luidybp/controlador_2_motores/PCB/Projeto/unifilar.kicad_pcb

## KiCad design PCB/Projeto/unifilar.kicad_pcb (2026-10-10)

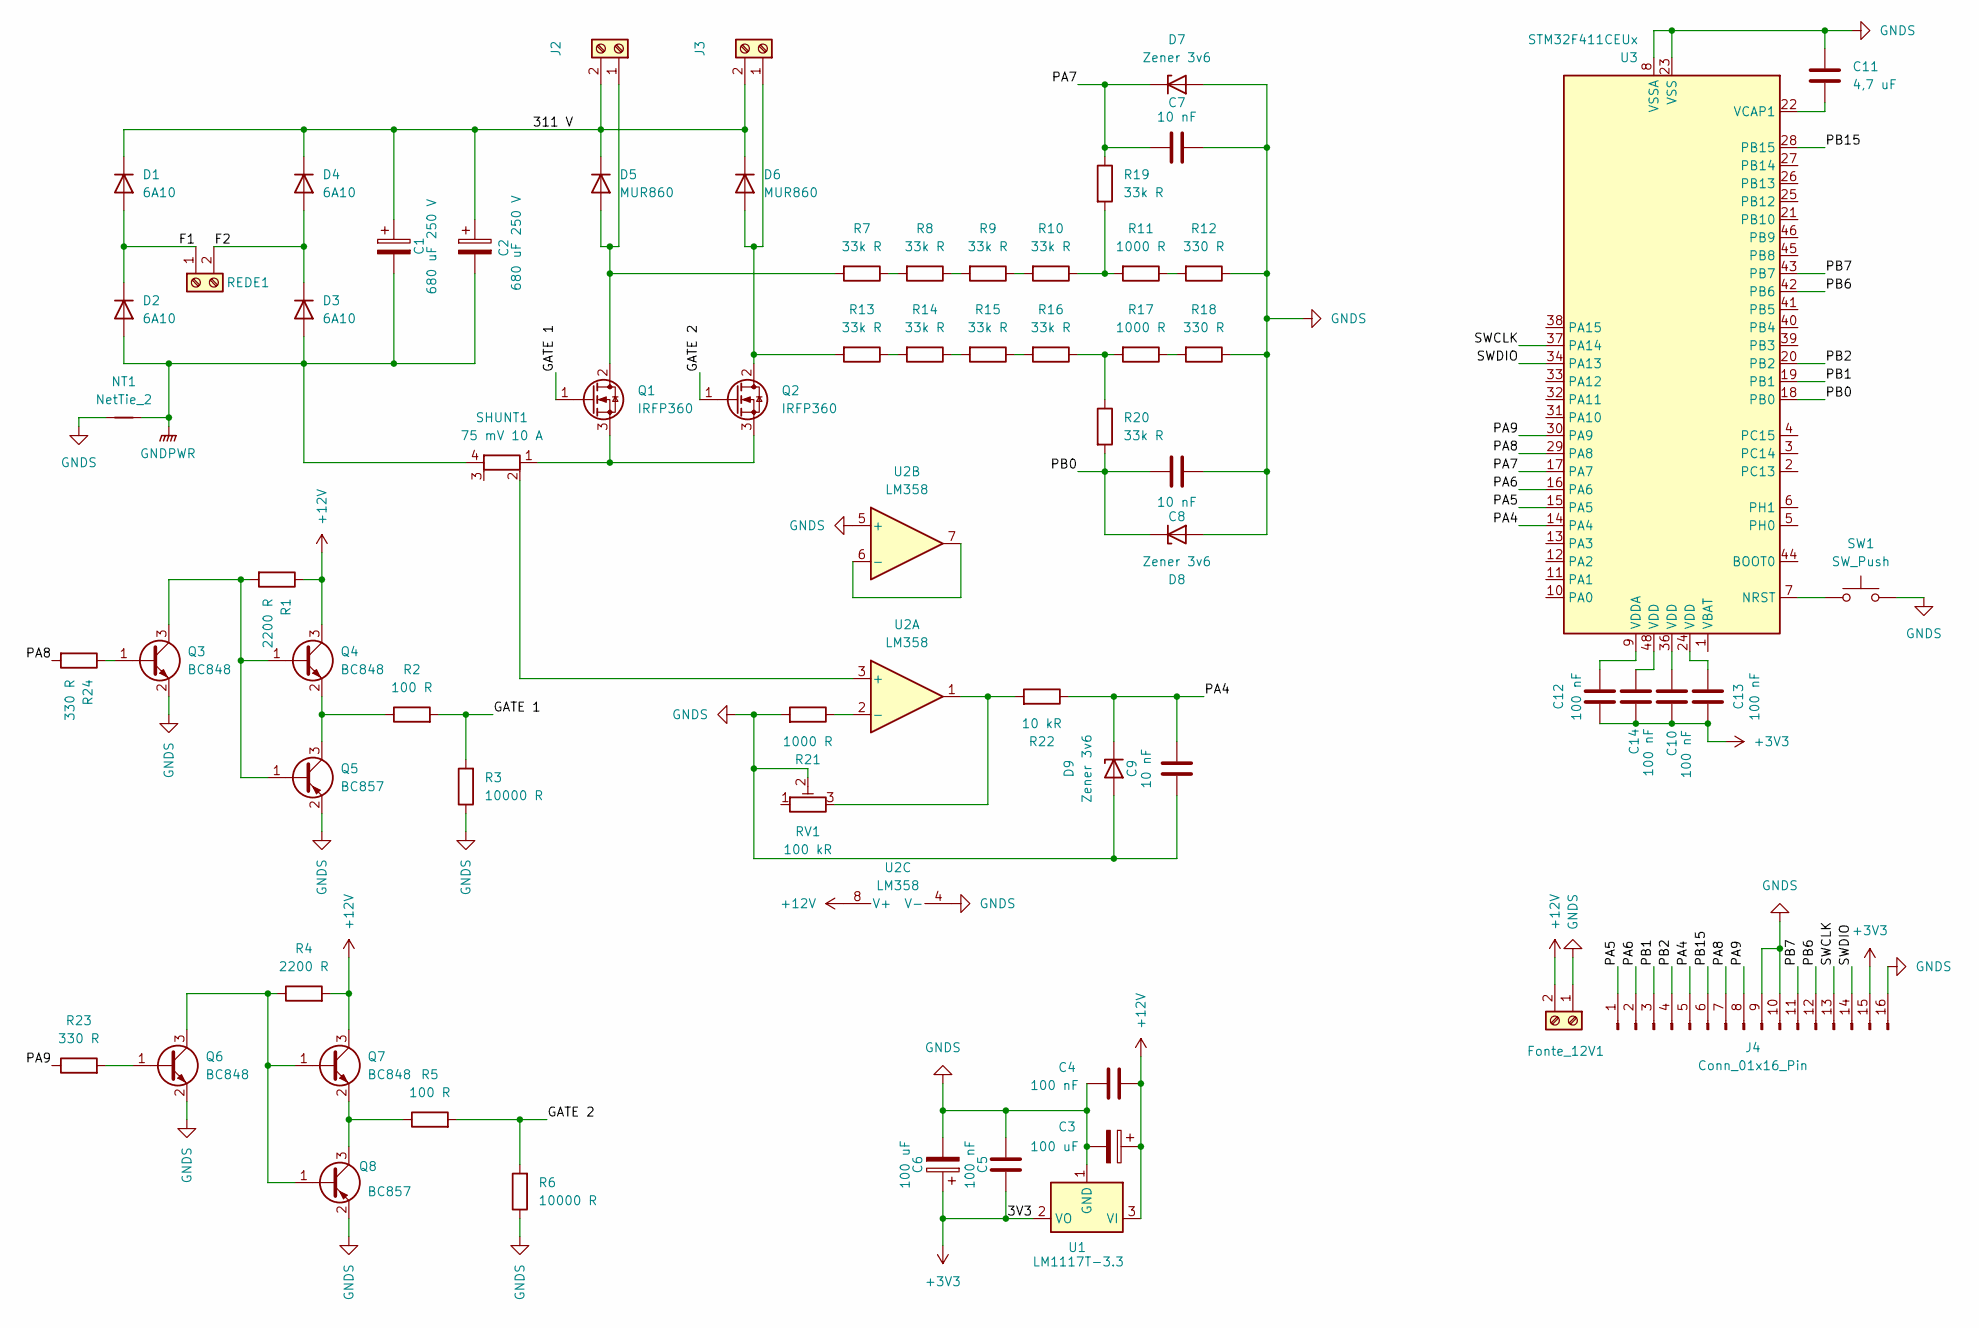
[picture p1: schematic unifilar.kicad_sch, Controlador dos motores CC]

Parts:
C1, C2: 680 uF 250 V; CP_Radial_D35.0mm_P10.00mm_SnapIn
C3, C6: 100 uF; CP_Elec_6.3x5.4
C4, C5, C10, C12, C13, C14: 100 nF; C_1206_3216Metric_Pad1.33x1.80mm_HandSolder
C7, C8, C9: 10 nF; C_1206_3216Metric_Pad1.33x1.80mm_HandSolder
C11: 4,7 uF; C_1206_3216Metric_Pad1.33x1.80mm_HandSolder
D1, D2, D3, D4: 6A10; D_5KPW_P12.70mm_Horizontal
D5, D6: MUR860; TO-220-2_Horizontal_TabUp
D7, D8, D9: Zener 3v6; D_SOD-123F
Fonte_12V1: TerminalBlock_Phoenix_MKDS-1,5-2-5.08_1x02_P5.08mm_Horizont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
J2, J3: TerminalBlock_Phoenix_MKDS-1,5-2-5.08_1x02_P5.08mm_Horizont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
J4: Conn_01x16_Pin; PinHeader_1x16_P1.00mm_Horizontal
NT1: NetTie_2; NetTie-2_SMD_Pad0.5mm
Q1, Q2: IRFP360; TO-247-3_Horizontal_TabUp
Q3, Q4, Q6, Q7: BC848; SOT-23
Q5, Q8: BC857; SOT-23
R1, R4: 2200 R; R_1206_3216Metric_Pad1.30x1.75mm_HandSolder
R2, R5: 100 R; R_1206_3216Metric_Pad1.30x1.75mm_HandSolder
R3, R6: 10000 R; R_1206_3216Metric_Pad1.30x1.75mm_HandSolder
R7, R8, R9, R10, R13, R14, R15, R16, R19, R20: 33k R; R_1206_3216Metric_Pad1.30x1.75mm_HandSolder
R11, R17, R21: 1000 R; R_1206_3216Metric_Pad1.30x1.75mm_HandSolder
R12, R18, R23, R24: 330 R; R_1206_3216Metric_Pad1.30x1.75mm_HandSolder
R22: 10 kR; R_1206_3216Metric_Pad1.30x1.75mm_HandSolder
REDE1: TerminalBlock_Phoenix_MKDS-1,5-2-5.08_1x02_P5.08mm_Horizont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
RV1: 100 kR; Potentiometer_Bourns_3296W_Vertical
SHUNT1: 75 mV 10 A; TerminalBlock_Phoenix_MKDS-1,5-4_1x04_P5.00mm_Horizontal
SW1: SW_Push; SW_PUSH_6mm
U1: LM1117T-3.3; TO-220-3_Horizontal_TabUp
U2: LM358
U3: STM32F411CEUx; QFN-48-1EP_7x7mm_P0.5mm_EP5.6x5.6mm

Connections:
+3V3: C5.2, C6.1, C10.1, C12.1, C13.1, C14.1, J4.15, U1.2 (VO)
+12V: C3.1, C4.2, Fonte_12V1.2, Q4.3 (C), Q7.3 (C), R1.1, R4.2, U1.3 (VI), U2.8 (V+)
/311 V: C1.1, C2.1, D1.1 (K), D4.1 (K), D5.1 (K), D6.1 (K), J2.2, J3.2
/F1: D1.2 (A), D2.1 (K), REDE1.1
/F2: D3.1 (K), D4.2 (A), REDE1.2
/GATE 1: Q1.1 (G), R2.2, R3.2
/GATE 2: Q2.1 (G), R5.2, R6.2
/PA4: C9.1, D9.1 (K), J4.5, R22.1, U3.14 (PA4)
/PA5: J4.1, U3.15 (PA5)
/PA6: J4.2, U3.16 (PA6)
/PA7: C7.1, D7.1 (K), R19.1, U3.17 (PA7)
/PA8: J4.7, R24.2, U3.29 (PA8)
/PA9: J4.8, R23.1, U3.30 (PA9)
/PB0: C8.1, D8.1 (K), R20.2, U3.18 (PB0)
/PB1: J4.3, U3.19 (PB1)
/PB2: J4.4, U3.20 (PB2)
/PB6: J4.12, U3.42 (PB6)
/PB7: J4.11, U3.43 (PB7)
/PB15: J4.6, U3.28 (PB15)
/SWCLK: J4.13, U3.37 (PA14)
/SWDIO: J4.14, U3.34 (PA13)
GNDPWR: C1.2, C2.2, D2.2 (A), D3.2 (A), NT1.1, SHUNT1.4
GNDS: C3.2, C4.1, C5.1, C6.2, C7.2, C8.2, C9.2, C11.1, D7.2 (A), D8.2 (A), D9.2 (A), Fonte_12V1.1, J4.9, J4.10, J4.16, NT1.2, Q3.2 (E), Q5.2 (E), Q6.2 (E), Q8.2 (E), R3.1, R6.1, R12.1, R18.1, R21.2, RV1.2, SW1.2, U1.1 (GND), U2.4 (V-), U2.5 (+), U3.8 (VSSA), U3.23 (VSS), U3.35 (VSS), U3.47 (VSS), U3.49 (VSS)
unnamed: C10.2, U3.36 (VDD)
unnamed: C13.2, U3.24 (VDD)
unnamed: C14.2, U3.48 (VDD)
unnamed: D5.2 (A), J2.1, Q1.2 (D), R7.2
unnamed: D6.2 (A), J3.1, Q2.2 (D), R13.2
unnamed: Q1.3 (S), Q2.3 (S), SHUNT1.1
unnamed: Q3.1 (B), R24.1
unnamed: Q3.3 (C), Q4.1 (B), Q5.1 (B), R1.2
unnamed: Q4.2 (E), Q5.3 (C), R2.1
unnamed: Q6.1 (B), R23.2
unnamed: Q6.3 (C), Q7.1 (B), Q8.1 (B), R4.1
unnamed: Q7.2 (E), Q8.3 (C), R5.1
unnamed: R7.1, R8.2
unnamed: R8.1, R9.2
unnamed: R10.1, R11.2, R19.2
unnamed: R9.1, R10.2
unnamed: R11.1, R12.2
unnamed: R13.1, R14.2
unnamed: R14.1, R15.2
unnamed: R15.1, R16.2
unnamed: R16.1, R17.2, R20.1
unnamed: R17.1, R18.2
unnamed: R22.2, RV1.3, U2.1
unnamed: SHUNT1.2, U2.3 (+)
unnamed: R21.1, U2.2 (-)
unnamed: U2.6 (-), U2.7
unnamed: SW1.1, U3.7 (NRST)
unnamed: C11.2, U3.22 (VCAP1)
unnamed: C12.2, U3.9 (VDDA)

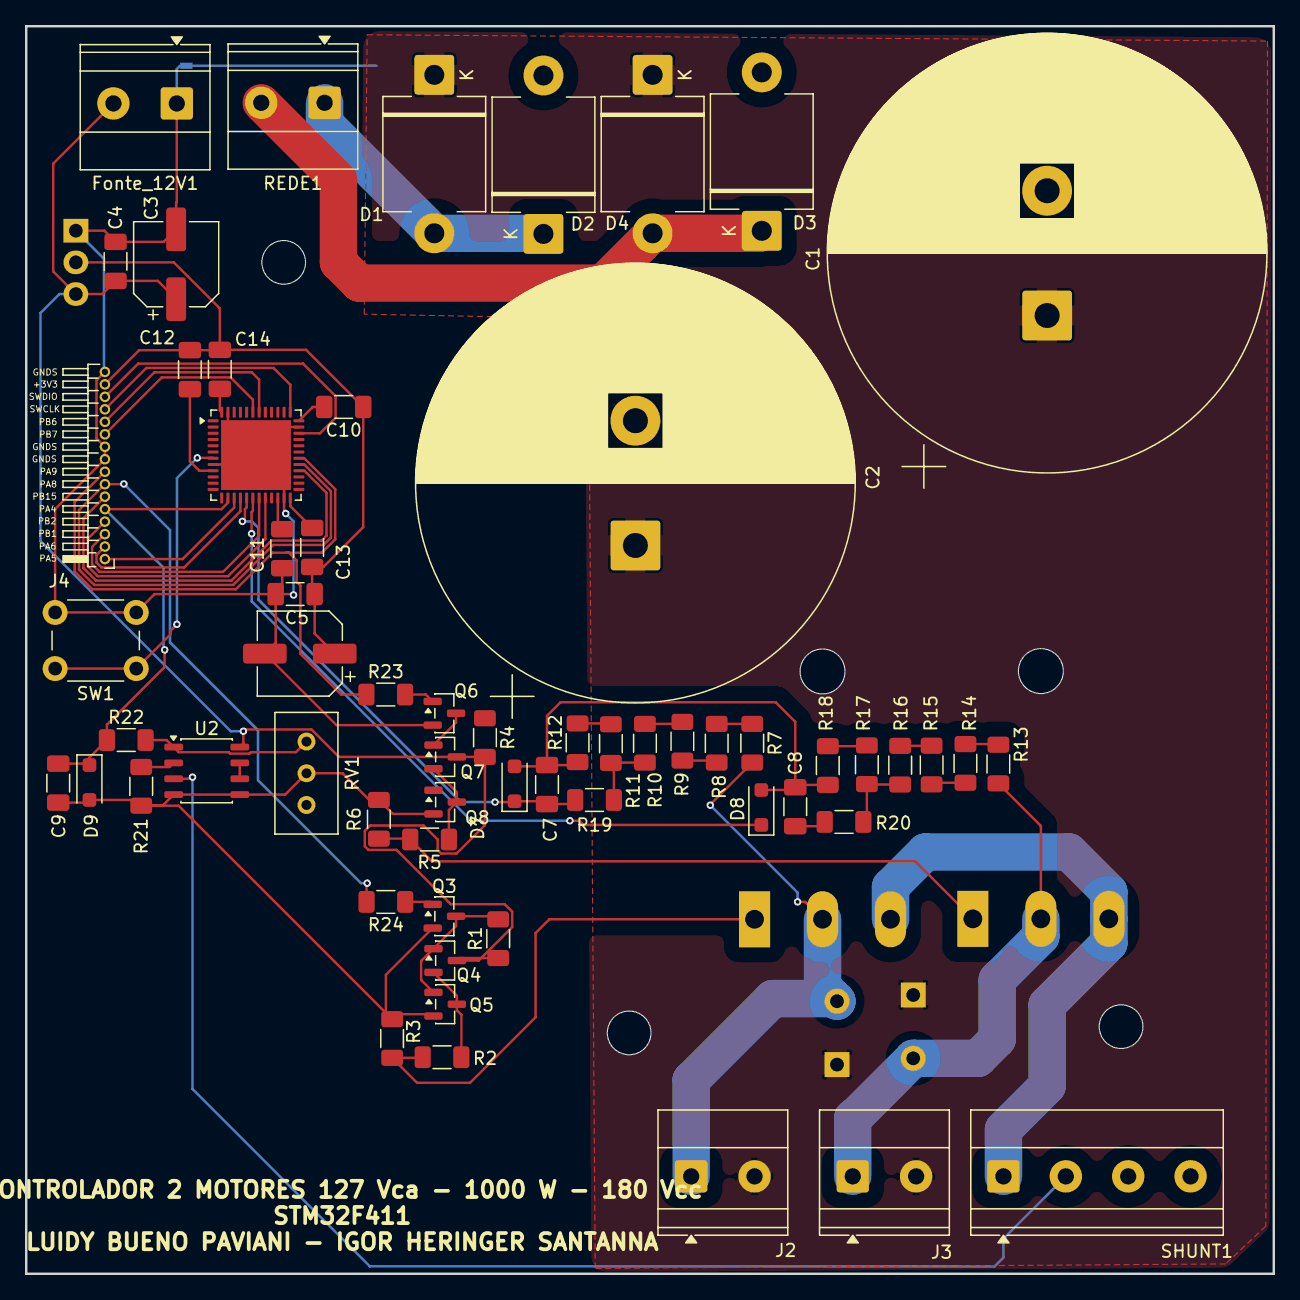
[picture p2: board unifilar.kicad_pcb from above]

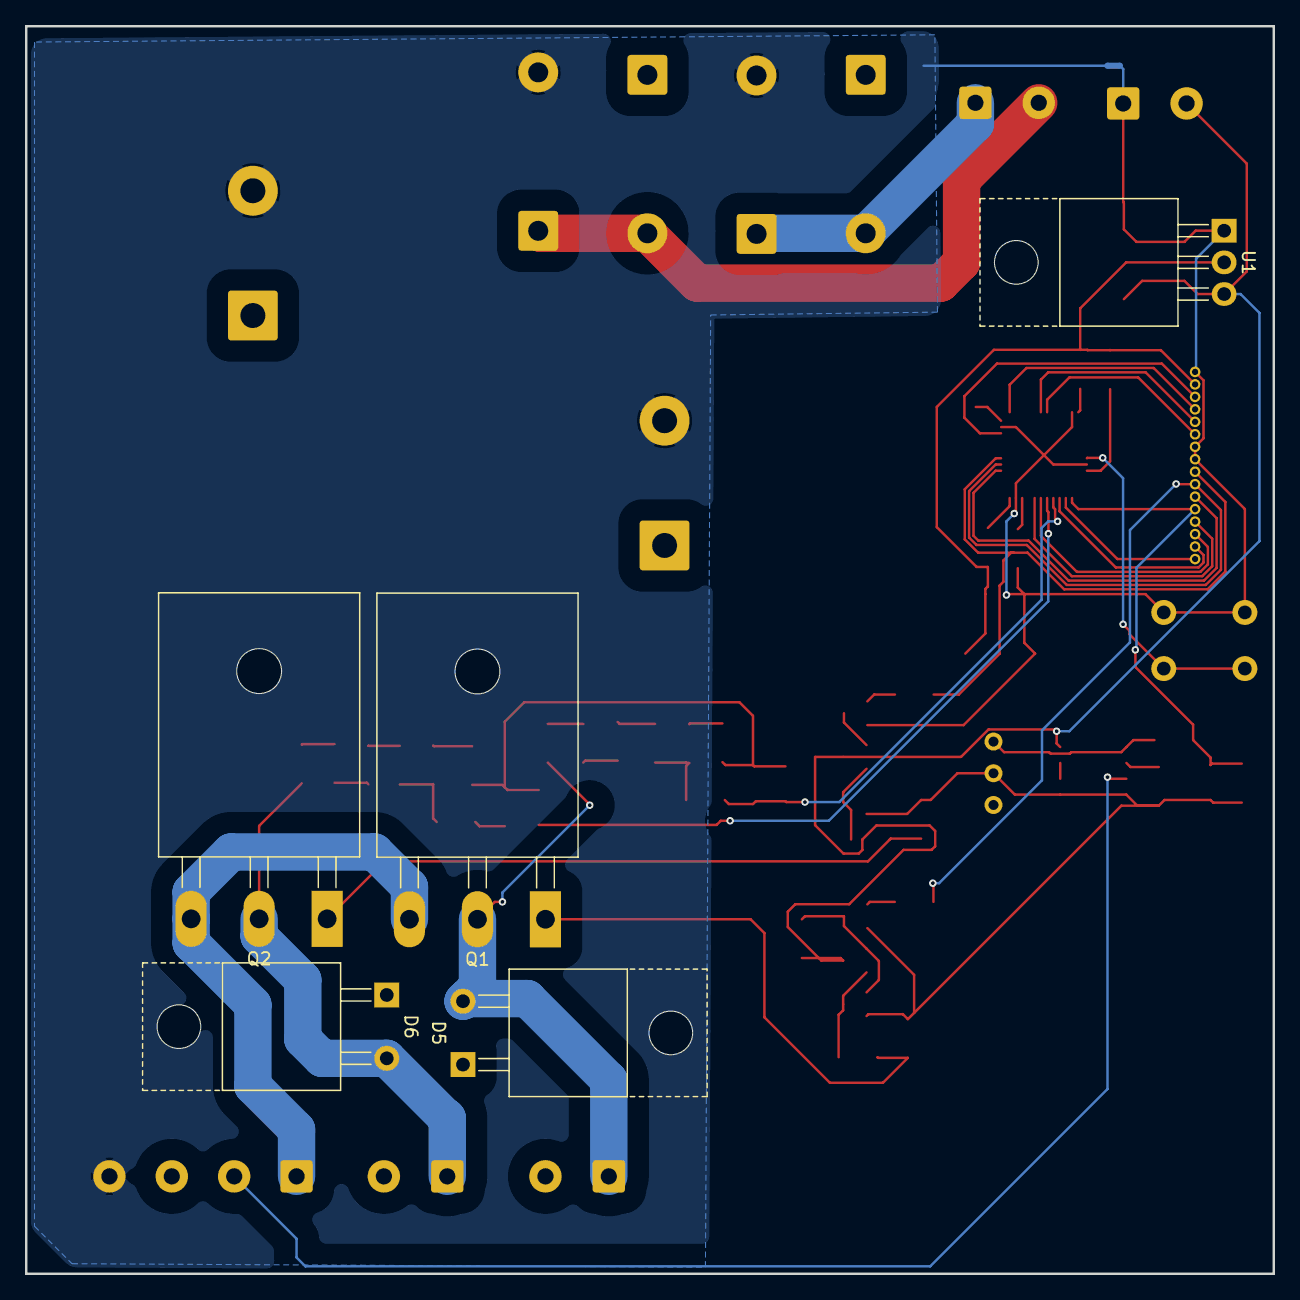
[picture p3: board unifilar.kicad_pcb from below]

Board: 2 copper layers, 100.0 x 100.0 mm, 67 parts (6 on the bottom side), 52 nets.
