luidybp/controlador_2_motores/tcc/tcc.ioc

Mcu.UserName=STM32F411CEUx
PA13.Signal=SYS_JTMS-SWDIO
PA14.Signal=SYS_JTCK-SWCLK
PA4.GPIO_Label=shunt
PA4.Signal=ADCx_IN4
PA5.GPIO_Label=pot1
PA5.Signal=ADCx_IN5
PA6.GPIO_Label=pot2
PA6.Signal=ADCx_IN6
PA7.GPIO_Label=emf1
PA7.Signal=ADCx_IN7
PA8.GPIO_Label=pwm1
PA8.Signal=S_TIM1_CH1
PA9.GPIO_Label=pwm2
PA9.Signal=S_TIM1_CH2
PB0.GPIO_Label=emf2
PB0.Signal=ADCx_IN8
PB15.GPIO_Label=bot
PB15.Signal=GPIO_Input
PC13-ANTI_TAMP.GPIO_Label=debug
PC13-ANTI_TAMP.Signal=GPIO_Output
