luidybp/controlador_2_motores/tcc/Core/Inc/main.h

#define debug_Pin GPIO_PIN_13
#define debug_GPIO_Port GPIOC
#define shunt_Pin GPIO_PIN_4
#define shunt_GPIO_Port GPIOA
#define pot1_Pin GPIO_PIN_5
#define pot1_GPIO_Port GPIOA
#define pot2_Pin GPIO_PIN_6
#define pot2_GPIO_Port GPIOA
#define emf1_Pin GPIO_PIN_7
#define emf1_GPIO_Port GPIOA
#define emf2_Pin GPIO_PIN_0
#define emf2_GPIO_Port GPIOB
#define bot_Pin GPIO_PIN_15
#define bot_GPIO_Port GPIOB
#define pwm1_Pin GPIO_PIN_8
#define pwm1_GPIO_Port GPIOA
#define pwm2_Pin GPIO_PIN_9
#define pwm2_GPIO_Port GPIOA
