luidybp/controlador_2_motores/(commit log)

2026-10-09 Projetos iniciais STM32F411
2026-10-10 Adiciona projeto KiCad da placa com modelo 3D
2026-10-16 alterações do PID e comentarios do gemini
2026-10-27 alteracao na funcao de pwm
2026-10-31 teste de tensao
